Rob-McKay/pico-w-network-meter/hardware/README.md

# Hardware

One folder per target:

| Folder | Target | What's there |
|---|---|---|
| [pico/](pico/README.md) | Raspberry Pi Pico W with a Pimoroni Pico Display Pack 2.0 | A battery-powered build in a 3D-printed case: the case generator and its STL files, the wiring diagram, the bill of materials and assembly |
| [xiao-esp32c5/](xiao-esp32c5/README.md) | Seeed XIAO ESP32-C5 with a 2.2" ILI9341 TFT | The wiring, power notes and bill of materials (no case yet), and Seeed's board documents in `vendor/` |

How to build, flash and use each target is in
[docs/targets/](../docs/targets/).
