Rob-McKay/pico-w-network-meter/docs/CODING.md

# Coding conventions

These follow [pi-zephyr-inet-radio](https://github.com/Rob-McKay/pi-zephyr-inet-radio)'s
conventions, cut down to what this project needs. They apply to the
repository's own C and Python. `make test` enforces what a tool can check:

| Rule | Checked by |
|---|---|
| 0. No compiler warnings, clean clang-tidy | the build itself (`cmake/strict.cmake`) |
| 0. Zephyr's coding style | `scripts/check-style.sh`: the repository's `.clang-format` (Zephyr's, plus two blank lines kept), `checkpatch.pl`, and `scripts/check-blank-lines.py` |
| 1. Doxygen comment on every function: parameters, return values, side effects (errno included) | `scripts/check-docs.py` |
| 2. Single responsibility | review |
| 3. No unbounded string functions; buffer overflows trapped | clang-tidy, and `_FORTIFY_SOURCE=2` in the firmware |
| 4. Zephyr's driver models first | review |
| 5. Every file includes the headers it uses itself | clang-tidy's `misc-include-cleaner` (sources), `scripts/check-header-includes.py` (headers) |
| 6. No magic numbers: named constants that say what they mean | clang-tidy's `readability-magic-numbers` |

Pull requests are reviewed against these rules with the checklist in
[.github/pull_request_template.md](../.github/pull_request_template.md),
which GitHub fills into every new pull request.
[CLAUDE.md](../CLAUDE.md) summarises them for Claude Code, which reads it
in every session on this repository.

**Two targets.** Every change must pass `make test`, which builds the
firmware for both, and `make pico` and `make xiao` must build with no
warnings from this repository's code. A pull request says what was tested
on each target's hardware (a Pico W with a Display Pack, a XIAO ESP32-C5
with its TFT), or that it wasn't. When behaviour, buttons, LED colours or
settings change, update the README, `docs/USAGE.md`, the quick reference
and the guide of every target the change affects (`docs/targets/`).

## 0. The build checks every file

Every target with our code calls `meter_strict_warnings()` from
`cmake/strict.cmake`, which:

- compiles with `-Wall -Wextra -Wpedantic -Werror`: any warning fails the
  build;
- runs clang-tidy (`.clang-tidy`, the same checks as the radio's) on each
  source as it compiles, all findings as errors. clang-tidy 20 or later
  must be installed (the Docker image has 23.1.3 from PyPI).
  `-DMETER_CLANG_TIDY=OFF` skips it for a quick local build only.

Zephyr's headers are included as system headers, so only this
repository's code is checked. `scripts/clang-tidy-cross.py` gives
clang-tidy the C library headers of the cross compile.

The compiler is clang (`cmake/toolchain.cmake`): Arm Toolchain for
Embedded for the Pico W, the host's clang for the native_sim tests. The
one exception is the XIAO ESP32-C5, built with the Zephyr SDK's GCC,
because Espressif's SoC support doesn't build with clang (its CMake adds
GCC-only flags and its assembly uses GCC syntax; see
[port-esp32c5.md](port-esp32c5.md), section 6). The same rules apply there:
GCC's warnings with `-Werror`, and clang-tidy, which the wrapper gives the
target, C library headers and the `-Wno-gnu` that Zephyr gives clang
builds. Shared code that only GCC accepts is a bug: it must build with
both compilers.

When a finding is a deliberate choice, suppress that one line with a
reason, never the whole check. The `#pragma GCC diagnostic` blocks around
Zephyr's file-scope `K_*_DEFINE` and `DEVICE_DT_INST_DEFINE` macros are
such a case: their expansion can end in an empty statement, which
`-Wpedantic` reports.

Formatting is Zephyr's: tabs, 100 columns, kernel brace style, as its
`.clang-format` lays out. The repository's `.clang-format` is Zephyr's,
copied unchanged between two marker lines, plus one addition: up to two
blank lines are kept, not one. Every function is followed by two blank
lines, before whatever comes next (an `#else`, `#elif` or `#endif` that
closes the function's conditional doesn't count, and the end of the file
needs none). clang-format can't require that, so
`scripts/check-blank-lines.py` checks it. `scripts/check-style.sh` also
checks that the copy still matches the pinned Zephyr's, so a Zephyr update
that changes its `.clang-format` fails the check until the copy is
refreshed. `scripts/check-style.sh --fix` (in `make shell`) reformats and
adds missing blank lines. Where clang-format would wrap a line that must
stay whole, such as a `NOLINTNEXTLINE`, fence it with
`/* clang-format off */` and `/* clang-format on */`.

## Concurrency

Three threads share data: main (display, buttons, LED), the scan thread
(`scan_task.c`) and the net_mgmt event thread (`scanner.c`'s callbacks).
Each shared variable has one mutex, named next to it, held for every
access; nothing is shared through plain globals. The display code
(`gfx.c`, `ui.c`) and the LED cache (`status_led.c`) are main-thread only
and say so. Struct copies are compared field by field (`chan_stats_equal()`),
never with `memcmp()`, which would also compare padding.

Two pieces of state are written from any thread or interrupt, because a
restart can start anywhere: the restart note (`reset_note.c`) is written
with interrupts locked, and a note that already holds a restart's reason
is never overwritten by the main loop's uptime update. The event log
(`event_log.c`) is main-thread only.

## 1. Every function has a Doxygen comment

- `@brief`: one line saying what the function does;
- `@param` for every parameter (`@param[out]`, `@param[in,out]` for
  pointers written through);
- `@return` or `@retval` lines, except for `void` functions;
- `@sideeffects`: every change the function makes to state outside its
  own locals and the objects its pointer parameters point to. That is:
  static and global variables written, with the lock held while doing so;
  hardware driven (the panel, LEDs, radio); queues, semaphores and work
  items given, taken or scheduled; threads started, woken or blocked;
  log messages; files written; and what happens to `errno`. Write
  "None (writes only through @p out)" or "None" when there are none.
  Effects of the functions it calls count too: name them ("Those of
  set_busy() and publish()") rather than leaving them out.

  In C the paragraph always says what happens to `errno`, even if only
  "errno unchanged". The meter's own functions never set `errno`: like
  Zephyr's, they return a negative errno code instead. Among the C library
  calls they make, only `snprintf()` can set it (on an output error).
  Python functions list their effects without `errno`: printing, files,
  subprocesses, exiting.

```c
/**
 * @brief Make a finished scan visible to the display thread.
 *
 * @param ret The scan's outcome (run_scan()).
 * @return The scan's number.
 *
 * @sideeffects Under @c lock: removes faded-out access points from
 *              @c history, merges @c scanning into it, and updates
 *              @c progress. errno unchanged.
 */
static unsigned int publish(int ret)
```

Python uses the same tags in `##` comment blocks, and CMake functions in
`#` comment blocks.

Where each comment goes:

- **Public functions** (declared in a header): the header holds the
  interface documentation above, at the declaration. The definition in the
  `.c` file has a plain `/*` comment (not a second doc block) saying it is
  part of the public interface and where that is documented, followed by
  any private implementation details a reader needs:

  ```c
  /*
   * Public interface: documented in chan_stats.h.
   *
   * Adds up every access point's power in mW (not dBm), each weighted by its
   * overlap with the channel (overlap_mhz()) over CHAN_WIDTH_MHZ.
   */
  void chan_stats_channel(const struct chan_stats *s, uint8_t channel, struct chan_info *out)
  ```

- **`static` functions and test cases** (`ZTEST`): the full doc block, at
  the definition. A test case's `@brief` says what it checks.

`scripts/check-docs.py` checks both: Doxygen's output for the doc blocks,
and the C sources for the comment above every definition.

## 2. Single responsibility

A function does one job at one level of abstraction. In particular,
hardware-independent logic (`chan_stats.c`, `text_raster.c`) stays free of
Zephyr device APIs so it can be unit tested on native_sim. The screens are
tested on a fake panel (`tests/ui_render`).

## 3. Strings and buffers

`strcpy`, `strcat`, `sprintf`, `vsprintf` and `gets` are banned (clang-tidy).
Use `snprintf`, or `memcpy` with an explicit length and terminator. The
firmware is built with `_FORTIFY_SOURCE=2`, so an overflow in a C library
call stops it instead of corrupting memory.

## 4. Zephyr's driver models first

The Display Pack is described in devicetree and used through Zephyr's
drivers: the ST7789V display driver, `gpio-keys` with the input subsystem,
and `gpio-leds` with the LED API. The Wi-Fi chip is used through Zephyr's
AIROC driver and Wi-Fi management API. Write a driver only when Zephyr has
none.

## 5. Include what you use

Every file, header or source, includes the headers that declare what it
uses itself, and doesn't rely on another header to bring them in. A file
that uses `uint8_t` includes `<stdint.h>`, even if its own header already
does; one that uses `struct chan_stats` includes `"chan_stats.h"`, even if
`ui.h` includes it too. A header can then change what it includes without
breaking the files that include it.

Take each symbol from its documented public header, not the internal one
that happens to define it: `<errno.h>` for `EINVAL` (not picolibc's
`<sys/errno.h>`), `<zephyr/kernel.h>` for the kernel API,
`<zephyr/ztest.h>` for `zassert_*`, `<zephyr/sys/util.h>` for
`ARRAY_SIZE` and `IS_ENABLED`. Some symbols have public headers of their
own that the aggregate headers also include: `<zephyr/toolchain.h>`
(`BUILD_ASSERT`, `ARG_UNUSED`), `<zephyr/devicetree.h>` (`DT_*`),
`<zephyr/sys/clock.h>` (`k_timeout_t`, `MSEC_PER_SEC`). Include those
directly.

clang-tidy's `misc-include-cleaner` checks the sources on every build, and
`scripts/check-header-includes.py` checks each header on its own, in
`make test`. `.clang-tidy` lists the internal headers whose symbols come
from a public header instead (`IgnoreHeaders`), and why. Only missing
includes are reported: an include that looks unused may be in use through
a devicetree or Kconfig macro the check can't follow, so removing one is
left to review.

## 6. No magic numbers

A number in the code says what it is through its name. Every number except
0 to 4 (counting, halving and doubling, as in `2 * PAD`) is a named
constant, a `#define`, an `enum` or a `const`, whose name gives its
meaning, with a comment for its units or where it comes from:

- a field's offset in a stored format: `REC_UPTIME`, not `8`
  (`boot_record.c`)
- a register's or a pixel's bits: `RGB565_R_SHIFT`, not `11` (`rgb565.h`)
- a colour: `RGB_HIGHLIGHT`, not `0, 210, 255` (`ui.c`)
- a buffer's size: `SCAN_TEXT_MAX`, with what it holds
- a radio fact: `CHAN_SPACING_MHZ`, `CHAN_14_MHZ` (`chan_stats.c`)

Use a constant the platform already names, such as Zephyr's
`BITS_PER_BYTE` or `MSEC_PER_SEC`, rather than defining another. A
character literal (`'?'`, `' '`) names itself. Where a number is tied to
another, write the relationship (`NOTE_AT_CAUSE + 1U`), and check it with
`BUILD_ASSERT` when it must hold (`REC_ARG + sizeof(uint32_t) ==
BOOT_RECORD_SIZE`). Settings a user might change are Kconfig options
(`CONFIG_METER_*`), not constants.

clang-tidy's `readability-magic-numbers` checks it on every build. The
tests are exempt (`tests/.clang-tidy`): their numbers are the inputs they
give and the results they expect, and read best as they are.
