Rob-McKay/pico-w-network-meter/hardware/pico/case/stl/back.png

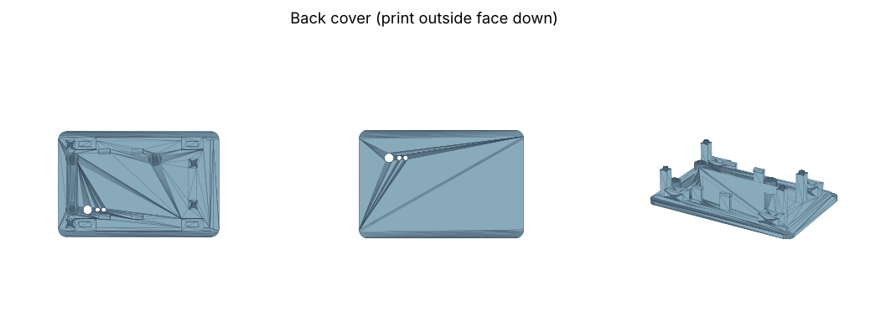
hardware/pico/case/stl/back.png
