Rob-McKay/pico-w-network-meter/hardware/pico/case/stl/buttons.png

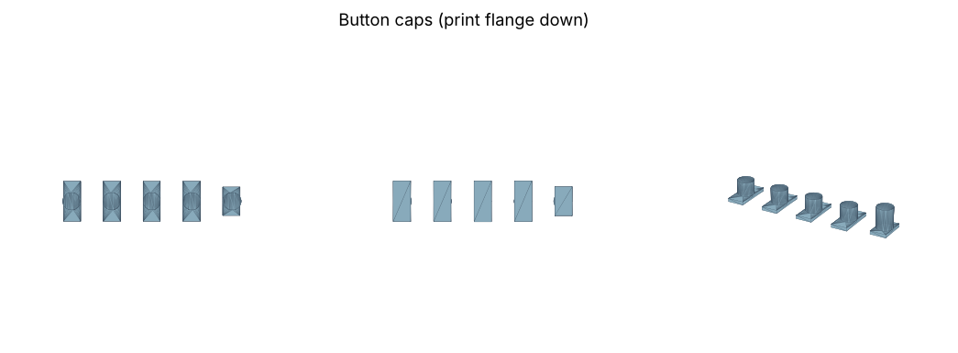
hardware/pico/case/stl/buttons.png
