Rob-McKay/pico-w-network-meter/hardware/pico/case/stl/front.png

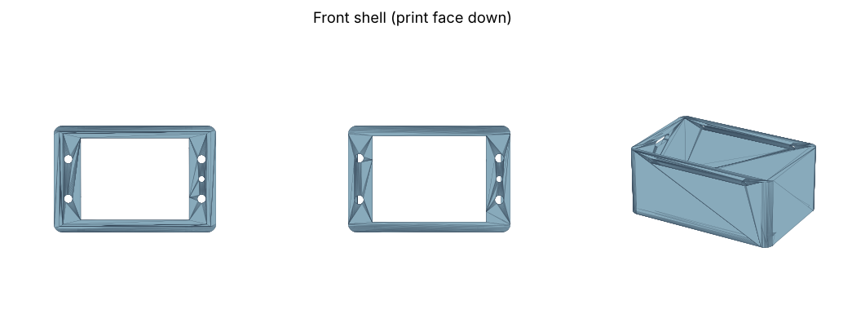
hardware/pico/case/stl/front.png
