Rob-McKay/pico-w-network-meter/hardware/pico/case/stl/back.stl

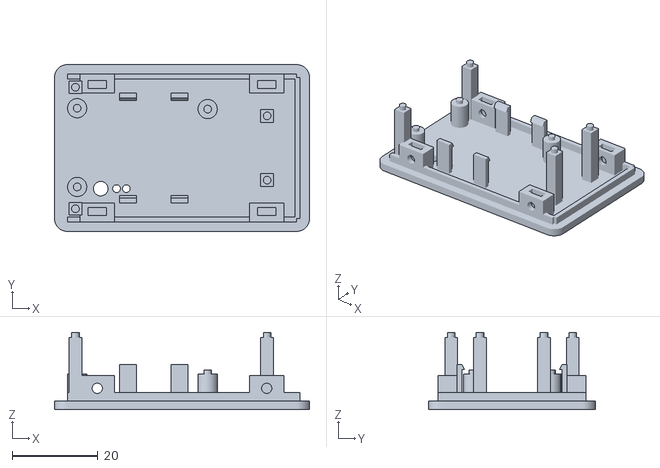
[picture p11: CAD file, 2026-11-06]
hardware/pico/case/stl/back.stl
59.6 x 39.0 x 18.1
