Rob-McKay/pico-w-network-meter/hardware/pico/case/stl/front.stl

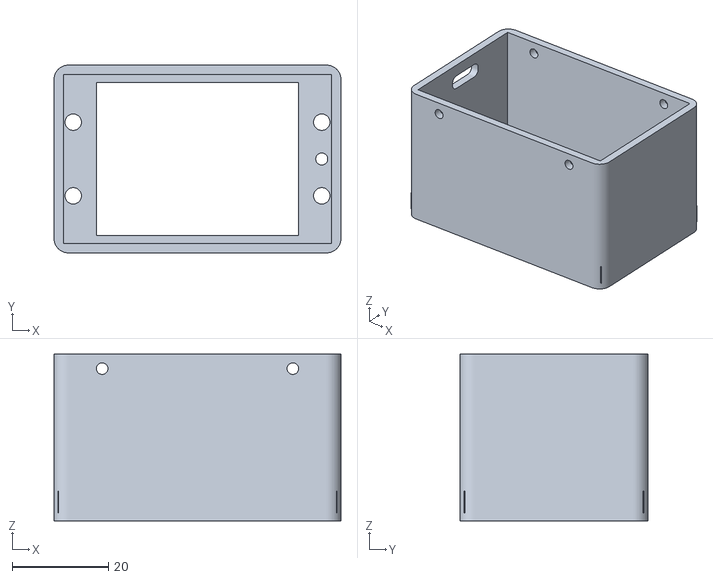
[picture p12: CAD file, 2026-11-06]
hardware/pico/case/stl/front.stl
59.6 x 39.0 x 34.6
