Rob-McKay/pico-w-network-meter/hardware/pico/case/stl/shelf.stl

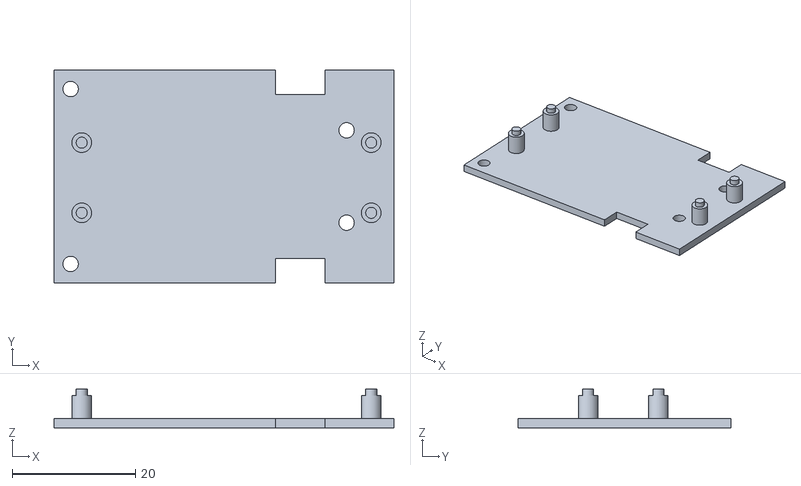
[picture p13: CAD file, 2026-11-06]
hardware/pico/case/stl/shelf.stl
55.2 x 34.6 x 6.30
