Rob-McKay/pico-w-network-meter/hardware/pico/case/stl/buttons.stl

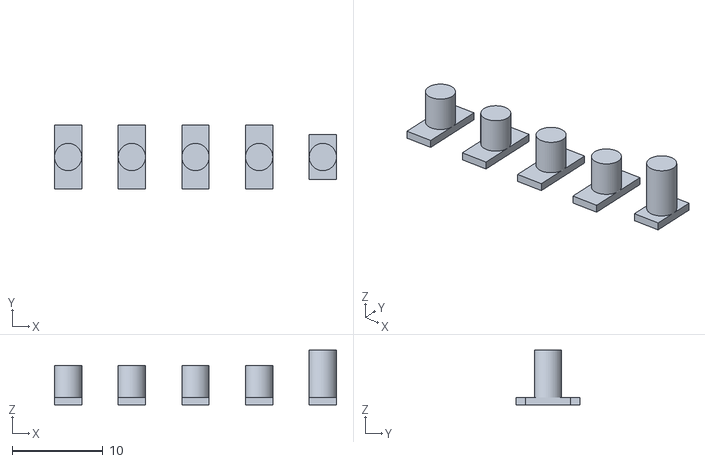
[picture p14: CAD file, 2026-11-03]
hardware/pico/case/stl/buttons.stl
31.0 x 7.00 x 6.00
