Rob-McKay/pico-w-network-meter/app/src/main.c

/*
 * Copyright (c) 2026 Rob McKay
 *
 * SPDX-License-Identifier: Apache-2.0
 *
 * Network meter: scans the 2.4 GHz Wi-Fi band every
 * CONFIG_METER_SCAN_INTERVAL_S seconds (scan_task.c) and shows per-channel
 * statistics on the display (zephyr,display: on the Pico W, a Pimoroni Pico
 * Display Pack 2.0), and on the serial console.
 *
 * Networks stay on screen after they were last heard: at full brightness
 * for CONFIG_METER_FADE_START_S seconds, then fading to
 * CONFIG_METER_FADE_MIN_PERCENT, and gone at CONFIG_METER_FADE_END_S. The screen is redrawn every
 * CONFIG_METER_REDRAW_MS while anything changes.
 *
 * Each start is logged in flash with why it happened (event_log.c,
 * reset_note.c), and shown on the events screen. A watchdog restarts the
 * meter if a thread stops responding (watchdog.c).
 *
 * Buttons: A next screen, B previous screen. On the channels screen X scans
 * now; on the networks and events screens X and Y page up and down a list
 * too long for the screen. On the events screen, X and Y together print the
 * whole log on the console.
 * RGB LED: blue while scanning, then green, amber or red for how busy the
 * recommended channel is; magenta if the latest scan failed.
 */

#include <stdbool.h>
#include <stddef.h>

#include <zephyr/input/input.h>
#include <zephyr/kernel.h>
#include <zephyr/logging/log.h>
#include <zephyr/logging/log_ctrl.h>
#include <zephyr/dt-bindings/input/input-event-codes.h>
#include <zephyr/sys/util.h>
#include <zephyr/toolchain.h>

#include "boot_record.h"
#include "chan_stats.h"
#include "controls.h"
#include "event_log.h"
#include "keys.h"
#include "paging.h"
#include "recommend.h"
#include "reset_cause.h"
#include "reset_note.h"
#include "scan_task.h"
#include "scanner.h"
#include "status_led.h"
#include "ui.h"
#include "watchdog.h"

LOG_MODULE_REGISTER(meter, CONFIG_METER_LOG_LEVEL);

/* Starts printed on the console at start-up, newest first. */
#define STARTS_ON_CONSOLE 10U
/* Longest description of a start, and a NUL. */
#define START_TEXT_MAX    40

/* Longest wait for the console to take a line of a log dump, in 10 ms
 * steps: 1 s.
 */
#define DUMP_WAIT_STEPS   100
#define DUMP_WAIT_STEP_MS 10

/* The main thread's watchdog channel; set by main() before the loop. */
static int main_watch = -1;

/* The main thread's watchdog deadline: it goes round every CONFIG_METER_REDRAW_MS. */
#define MAIN_DEADLINE_MS 5000U
BUILD_ASSERT(MAIN_DEADLINE_MS >= 4U * CONFIG_METER_REDRAW_MS,
	     "the main thread's watchdog deadline must allow several redraws");

/**
 * @brief Map how busy a channel is to the LED status that shows it.
 *
 * @param level How busy.
 * @return Green, amber or red status.
 *
 * @sideeffects None; errno unchanged.
 */
static enum status level_status(enum chan_level level)
{
	switch (level) {
	case CHAN_LEVEL_BUSY:
		return STATUS_BUSY;
	case CHAN_LEVEL_MODERATE:
		return STATUS_MODERATE;
	default:
		return STATUS_CLEAR;
	}
}


/**
 * @brief Pick the LED status: scanning (or no scan finished yet), failed,
 *        or how busy the recommended channel (on 5 GHz, 80 MHz block) is.
 *
 * @param s The networks showing.
 * @param state The scan thread's progress.
 * @param band The band whose recommendation counts: the last channels
 *        screen's.
 * @return The status.
 *
 * @sideeffects None; errno unchanged.
 */
static enum status led_status(const struct chan_stats *s, const struct scan_task_state *state,
			      enum chan_band band)
{
	struct chan_info best;

	if (state->busy || state->scans == 0U) {
		return STATUS_SCANNING;
	}
	if (state->last_error != 0) {
		return STATUS_ERROR;
	}
	if (band == CHAN_BAND_5G) {
		chan_stats_block_5g(s, recommend_5g(s), &best);
	} else {
		chan_stats_channel(s, chan_stats_recommend(s), &best);
	}

	return level_status(chan_stats_level(best.interference));
}


/* A screen A and B step through: a view, and for a channels or networks
 * screen its band.
 */
struct page {
	enum ui_view view;
	enum chan_band band; /* CHAN_BAND_COUNT: keep the band of the screen before */
};

/* The screens in order: each band's channels and networks, side by side,
 * then the events. The 5 GHz ones are left out without
 * CONFIG_METER_BAND_5G.
 */
static const struct page pages[] = {
	{UI_VIEW_CHANNELS, CHAN_BAND_2G4}, {UI_VIEW_NETWORKS, CHAN_BAND_2G4},
	{UI_VIEW_CHANNELS, CHAN_BAND_5G},  {UI_VIEW_NETWORKS, CHAN_BAND_5G},
	{UI_VIEW_EVENTS, CHAN_BAND_COUNT},
};

/* What the screen shows, to redraw only when something changes. */
struct screen {
	size_t page;              /* index in pages[] */
	enum ui_view view;        /* pages[page].view */
	enum chan_band band;      /* the band of the last channels or networks screen:
				   * the LED shows its recommendation
				   */
	size_t first;             /* networks or events screen: first row shown */
	bool full;                /* the whole screen needs drawing */
	unsigned int drawn_scans; /* scan count on screen */
	struct chan_stats shown;  /* networks on screen */
};

/**
 * @brief Change the screen shown, back to the top of its list.
 *
 * Steps through pages[], skipping the 5 GHz screens without
 * CONFIG_METER_BAND_5G. A channels or networks screen sets the band; the
 * events screen keeps it.
 *
 * @param[in,out] scr What is on screen.
 * @param step 1 for the next screen, -1 (or any other value) for the
 *        previous one.
 *
 * @sideeffects None (writes only through @p scr); errno unchanged.
 */
static void change_view(struct screen *scr, int step)
{
	const size_t n = ARRAY_SIZE(pages);

	do {
		scr->page = (scr->page + (step > 0 ? 1U : n - 1U)) % n;
	} while (!IS_ENABLED(CONFIG_METER_BAND_5G) && pages[scr->page].band == CHAN_BAND_5G);
	scr->view = pages[scr->page].view;
	if (pages[scr->page].band != CHAN_BAND_COUNT) {
		scr->band = pages[scr->page].band;
	}
	scr->first = 0;
}


/**
 * @brief Count the rows of the list on screen.
 *
 * @param scr What is on screen.
 * @return Networks or events; 0 on the channels screen.
 *
 * @sideeffects None; errno unchanged.
 */
static size_t list_length(const struct screen *scr)
{
	switch (scr->view) {
	case UI_VIEW_NETWORKS:
		return chan_stats_band_count(&scr->shown, scr->band);
	case UI_VIEW_EVENTS:
		return event_log_count();
	default:
		return 0;
	}
}


/**
 * @brief Page the list on screen up or down.
 *
 * @param[in,out] scr What is on screen.
 * @param down Down a page if true, up if false.
 * @return True if the page changed.
 *
 * @sideeffects None (writes only through @p scr); errno unchanged.
 */
static bool page_list(struct screen *scr, bool down)
{
	size_t was = scr->first;

	scr->first = paging_move(scr->first, down, list_length(scr), ui_list_rows());

	return scr->first != was;
}


/**
 * @brief Wait for the console to take what has been logged, feeding the
 *        watchdog meanwhile.
 *
 * Wakes the log thread first: left alone, it sleeps for
 * CONFIG_LOG_PROCESS_THREAD_SLEEP_MS (1 s) until CONFIG_LOG_PROCESS_TRIGGER_THRESHOLD
 * messages are waiting, so every line would take the whole wait.
 *
 * @return True if it did, false if it is still busy after a second (no
 *         one reading it).
 *
 * @sideeffects Wakes the log thread (log_thread_trigger()); sleeps the main thread, in 10 ms
 *              steps, up to 1 s; feeds @c main_watch. errno unchanged.
 */
static bool wait_for_console(void)
{
	log_thread_trigger();
	for (int i = 0; i < DUMP_WAIT_STEPS && log_data_pending(); i++) {
		watchdog_feed(main_watch);
		k_msleep(DUMP_WAIT_STEP_MS);
	}
	watchdog_feed(main_watch);

	return !log_data_pending();
}


/**
 * @brief Log one start with all its details (event_log_dump() function).
 *
 * Stops logging once the console has stopped keeping up.
 *
 * @param r The start.
 * @param arg The dump's flag (bool): set once the console stops keeping up.
 *
 * @sideeffects Logs the start; those of wait_for_console(). errno may be set by snprintf()
 *              (only on an output error).
 */
static void log_one_start(const struct boot_record *r, void *arg)
{
	bool *stalled = arg;
	char text[START_TEXT_MAX];

	if (*stalled) {
		return;
	}
	boot_record_describe(r, text, sizeof(text));
	if (r->hw_reset == BOOT_HW_UNKNOWN) {
		LOG_INF("%s: cause %u, ran %u s, detail %d, arg 0x%08x", text,
			(unsigned int)r->cause, (unsigned int)r->uptime_s, (int)r->detail,
			(unsigned int)r->arg);
	} else {
		LOG_INF("%s: cause %u, ran %u s, detail %d, arg 0x%08x, hw %u", text,
			(unsigned int)r->cause, (unsigned int)r->uptime_s, (int)r->detail,
			(unsigned int)r->arg, (unsigned int)r->hw_reset);
	}
	*stalled = !wait_for_console();
}


/**
 * @brief Log the whole event log from flash, oldest first, with all the
 *        details, a line at a time as the console takes them.
 *
 * @sideeffects Reads the flash log; logs it, and says on the footer that it did; blocks the
 *              main thread while the console takes it, feeding the watchdog. errno may be set
 *              by snprintf() (only on an output error).
 */
static void dump_log(void)
{
	bool stalled = false;
	int n;

	LOG_INF("Event log, oldest first:");
	stalled = !wait_for_console();
	n = event_log_dump(log_one_start, &stalled);
	if (n < 0) {
		LOG_ERR("Event log unavailable: %d", n);
	} else if (stalled) {
		LOG_WRN("Event log dump stopped: the console isn't reading");
	} else {
		LOG_INF("End of event log: %d starts", n);
	}
	ui_message("Event log sent to the console");
}


/**
 * @brief Act on a button: A and B change the screen; X and Y page the
 *        networks and events screens, and X scans now on the channels
 *        screen; X and Y together on the events screen dump the log.
 *
 * @param key Key code from controls_wait(), or a negative errno.
 * @param[in,out] scr What is on screen.
 * @return True if the screen needs redrawing in full.
 *
 * @sideeffects Writes @p scr through its pointer; X on the channels screen wakes the scan
 *              thread (scan_task_request()); X and Y together on the events screen log the
 *              whole event log (dump_log()). errno may be set by snprintf() (only on an output
 *              error).
 */
static bool handle_key(int key, struct screen *scr)
{
	bool list = scr->view != UI_VIEW_CHANNELS;

	switch (key) {
	case INPUT_KEY_A:
		change_view(scr, 1);
		return true;
	case INPUT_KEY_B:
		change_view(scr, -1);
		return true;
	case INPUT_KEY_X:
		if (list) {
			return page_list(scr, false);
		}
		scan_task_request();
		return false;
	case INPUT_KEY_Y:
		return list && page_list(scr, true);
	case KEYS_X_AND_Y:
		if (scr->view == UI_VIEW_EVENTS) {
			dump_log();
		}
		return false;
	default:
		return false;
	}
}


/**
 * @brief Redraw the screen if the networks, their fading, the scan count
 *        or the view have changed.
 *
 * @param[in,out] scr What is on screen.
 * @param next The networks to show.
 * @param scans Scans finished so far.
 *
 * The page shown is kept within the list, which may have shrunk.
 *
 * @sideeffects Draws on the panel (ui_show()) and updates @p scr. errno may be set by
 *              snprintf() (only on an output error).
 */
static void update_screen(struct screen *scr, const struct chan_stats *next, unsigned int scans)
{
	if (!scr->full && scans == scr->drawn_scans && chan_stats_equal(next, &scr->shown)) {
		return;
	}
	scr->shown = *next;
	scr->first = paging_clamp(scr->first, list_length(scr), ui_list_rows());
	ui_show(scr->view, scr->band, &scr->shown, scans, scr->first, scr->full);
	scr->drawn_scans = scans;
	scr->full = false;
}


/**
 * @brief Start the display, LEDs and buttons.
 *
 * Failures are logged; the meter carries on with what works.
 *
 * @sideeffects Initialises the button queue, the display (cleared) and the LEDs (backlight on,
 *              RGB LED off), and writes "Scanning..." in the footer; logs failures. errno may
 *              be set by snprintf() (only on an output error).
 */
static void start_io(void)
{
	controls_init();
	/* Clear the panel before the backlight shows its power-on contents. */
	if (ui_init() != 0) {
		LOG_ERR("Display not ready: console output only");
	}
	if (status_init() != 0) {
		LOG_ERR("LEDs not ready");
	}
	ui_message("Scanning...");
}


/**
 * @brief Record this start in the flash log, with why it happened.
 *
 * Takes the note the run before left (reset_note_take()) first, before
 * anything else can restart the meter. With CONFIG_METER_RESET_CAUSE,
 * the record also keeps the hardware's reset cause (reset_cause_take()).
 *
 * @retval 0 Recorded, or the log is open but the record couldn't be added.
 * @retval <0 Negative errno from event_log_init(): there is no log.
 *
 * @sideeffects Those of reset_note_take(), reset_cause_take() (with
 *              CONFIG_METER_RESET_CAUSE), event_log_init() and event_log_add(): starts
 *              this run's note, reads and clears the hardware's reset cause, reads and writes
 *              the flash log. errno unchanged.
 */
static int record_start(void)
{
	struct boot_note note;
	struct boot_record r;
	int ret;

	reset_note_take(&note);
	ret = event_log_init();
	if (ret != 0) {
		return ret;
	}
	boot_record_from_note(&note, event_log_last_boot() + 1U, &r);
	if (IS_ENABLED(CONFIG_METER_RESET_CAUSE)) {
		r.hw_reset = reset_cause_take();
	}
	(void)event_log_add(&r);

	return 0;
}


/**
 * @brief Print the newest starts on the console.
 *
 * @sideeffects Logs up to STARTS_ON_CONSOLE lines. errno may be set by snprintf() (only on an
 *              output error).
 */
static void print_starts(void)
{
	char text[START_TEXT_MAX];

	for (size_t i = 0; i < MIN(event_log_count(), (size_t)STARTS_ON_CONSOLE); i++) {
		const struct boot_record *e = event_log_get(i);

		boot_record_describe(e, text, sizeof(text));
		LOG_INF("Start %s (detail %d, 0x%08x)", text, (int)e->detail, (unsigned int)e->arg);
	}
}


/**
 * @brief Bring the event log up for this run: record this start, print the
 *        newest, hand them to the events screen.
 *
 * @sideeffects Those of record_start() and print_starts(); gives the UI its event source
 *              (ui_set_events()). errno may be set by snprintf() (only on an output error).
 */
static void log_start(void)
{
	if (record_start() != 0) {
		return;
	}
	print_starts();
	ui_set_events(event_log_count(), event_log_get);
}


/**
 * @brief Entry point: start the display and Wi-Fi, then redraw for ever.
 *
 * @return 0 if the Wi-Fi interface is missing (nothing else to do).
 *
 * @sideeffects Runs for ever: logs the start (log_start()), starts the watchdog and the scan
 *              thread, and drives the display, the RGB LED and the button queue; sets and feeds
 *              the main thread's watchdog channel (@c main_watch) and keeps the restart note's
 * uptime. Returns only if there is no Wi-Fi interface. errno may be set by snprintf() (only on an
 *              output error).
 */
int main(void)
{
	/* Static: struct screen holds a whole scan, too big for the stack. */
	static struct screen scr = {
		.page = 0,
		.view = UI_VIEW_CHANNELS,
		.band = CHAN_BAND_2G4,
		.full = true,
	};
	static struct chan_stats next;

	log_start();
	start_io();
	if (scanner_init() != 0) {
		ui_message("No Wi-Fi interface");
		status_set(STATUS_ERROR);
		return 0;
	}
	(void)watchdog_init();
	main_watch = watchdog_add(BOOT_WATCHED_MAIN, MAIN_DEADLINE_MS);
	scan_task_start();

	for (;;) {
		struct scan_task_state state;

		watchdog_feed(main_watch);
		reset_note_alive(k_uptime_get());

		if (handle_key(controls_wait(K_MSEC(CONFIG_METER_REDRAW_MS)), &scr)) {
			scr.full = true;
		}
		scan_task_snapshot(k_uptime_get(), &next, &state);
		status_set(led_status(&next, &state, scr.band));
		if (state.scans > 0U) { /* "Scanning..." until the first scan ends */
			update_screen(&scr, &next, state.scans);
		}
	}
}
