Rob-McKay/pico-w-network-meter/app/src/controls.c

/*
 * Copyright (c) 2026 Rob McKay
 *
 * SPDX-License-Identifier: Apache-2.0
 */

#include <errno.h>
#include <stdint.h>

#include <zephyr/dt-bindings/input/input-event-codes.h>
#include <zephyr/input/input.h>
#include <zephyr/kernel.h>
#include <zephyr/sys/clock.h>
#include <zephyr/sys/atomic.h>
#include <zephyr/toolchain.h>

#include "controls.h"
#include "keys.h"

/* Presses not yet taken by controls_wait(). */
#define QUEUED_PRESSES 4

/* Set up by controls_init(); K_MSGQ_DEFINE cannot make the queue static. */
static uint16_t press_buf[QUEUED_PRESSES];
static struct k_msgq presses;
static atomic_t ready;
/* Keys held down: the input thread only. */
static struct keys_state held;

/**
 * @brief Queue a button press, or X and Y pressed together (input thread).
 *
 * @param evt Input event.
 * @param user_data Unused.
 *
 * @sideeffects Updates @c held (keys_event()); puts the press on the @c presses queue (input
 *              thread); a press is dropped if the queue is full. errno unchanged.
 */
static void on_input(struct input_event *evt, void *user_data)
{
	int press;
	uint16_t code;

	ARG_UNUSED(user_data);
	if (atomic_get(&ready) == 0 || evt->type != INPUT_EV_KEY) {
		return;
	}
	press = keys_event(&held, evt->code, evt->value != 0);
	if (press < 0) {
		return;
	}
	code = (uint16_t)press;
	/* A full queue drops the press: the user pressed faster than the screen
	 * could follow.
	 */
	(void)k_msgq_put(&presses, &code, K_NO_WAIT);
}


INPUT_CALLBACK_DEFINE(NULL, on_input, NULL);

/*
 * Public interface: documented in controls.h.
 *
 * The ready flag is set after the queue is initialised. Zephyr's atomics are sequentially
 * consistent, so on_input() never sees the flag set before the queue exists.
 */
void controls_init(void)
{
	k_msgq_init(&presses, (char *)press_buf, sizeof(press_buf[0]), QUEUED_PRESSES);
	atomic_set(&ready, 1);
}


/*
 * Public interface: documented in controls.h.
 */
int controls_wait(k_timeout_t timeout)
{
	uint16_t code;

	if (k_msgq_get(&presses, &code, timeout) != 0) {
		return -EAGAIN;
	}

	return code;
}
