Rob-McKay/pico-w-network-meter/app/src/controls.h

/*
 * Copyright (c) 2026 Rob McKay
 *
 * SPDX-License-Identifier: Apache-2.0
 *
 * The meter's four buttons (A, B, X, Y), through Zephyr's input
 * subsystem (gpio-keys in the board overlay; on the Pico W, the Display
 * Pack's buttons).
 */

#ifndef METER_CONTROLS_H_
#define METER_CONTROLS_H_

#include <zephyr/kernel.h>
#include <zephyr/sys/clock.h>

/**
 * @brief Start queueing button presses.
 *
 * Call once, before controls_wait(); presses before it are ignored.
 *
 * @sideeffects Initialises the @c presses queue and sets @c ready, after which the input
 *              callback queues presses. errno unchanged.
 */
void controls_init(void);

/**
 * @brief Wait for a button press.
 *
 * Presses are queued (a few) between calls; releases are ignored.
 *
 * @param timeout Longest wait.
 * @return The button's key code (INPUT_KEY_A, INPUT_KEY_B, INPUT_KEY_X or
 *         INPUT_KEY_Y), KEYS_X_AND_Y for X and Y pressed together (keys.h),
 *         or -EAGAIN if none was pressed in time.
 *
 * @sideeffects Takes the oldest press off the @c presses queue; blocks the calling thread for
 *              up to @p timeout. errno unchanged.
 */
int controls_wait(k_timeout_t timeout);

#endif /* METER_CONTROLS_H_ */
