Rob-McKay/pico-w-network-meter/app/src/gfx.c

/*
 * Copyright (c) 2026 Rob McKay
 *
 * SPDX-License-Identifier: Apache-2.0
 */

#include <errno.h>
#include <stdbool.h>
#include <stddef.h>
#include <stdint.h>

#include <zephyr/device.h>
#include <zephyr/display/cfb.h>
#include <zephyr/drivers/display.h>
#include <zephyr/dt-bindings/display/panel.h>
#include <zephyr/logging/log.h>
#include <zephyr/sys/iterable_sections.h>
#include <zephyr/sys/util.h>
#include <zephyr/devicetree.h>
#include <zephyr/toolchain.h>

#include "gfx.h"
#include "rgb565.h"
#include "text_raster.h"

LOG_MODULE_REGISTER(gfx, CONFIG_METER_LOG_LEVEL);

/* Widest display supported, in pixels. */
#define MAX_WIDTH  320
/* Tallest font supported, in pixels: a band is one line of text. */
#define MAX_FONT_H 24

#define DISPLAY_NODE DT_CHOSEN(zephyr_display)

/* text_raster.c draws RGB565 high byte first, as the panel takes it over
 * SPI; the display driver may not be able to change format at run time (the
 * ST7789V's cannot).
 */
BUILD_ASSERT(DT_PROP(DISPLAY_NODE, pixel_format) == PANEL_PIXEL_FORMAT_RGB_565X,
	     "zephyr,display: set pixel-format = <PANEL_PIXEL_FORMAT_RGB_565X>");

static const struct device *const display = DEVICE_DT_GET(DISPLAY_NODE);

/* One line of text, or a strip of a filled rectangle. */
static uint16_t band[MAX_WIDTH * MAX_FONT_H];
static int disp_w;
static int disp_h;

/*
 * Public interface: documented in gfx.h.
 */
uint16_t gfx_rgb(uint8_t r, uint8_t g, uint8_t b)
{
	return raster_rgb(r, g, b);
}


/*
 * Public interface: documented in gfx.h.
 */
uint16_t gfx_fade(uint16_t color, uint8_t level)
{
	return rgb565x_fade(color, level);
}


/*
 * Public interface: documented in gfx.h.
 *
 * Checks the panel's pixel format at run time as well: the BUILD_ASSERT above covers only the
 * devicetree.
 */
int gfx_init(uint16_t bg)
{
	struct display_capabilities caps;

	if (!device_is_ready(display)) {
		LOG_ERR("Display not ready");
		return -ENODEV;
	}
	display_get_capabilities(display, &caps);
	if (caps.current_pixel_format != PIXEL_FORMAT_RGB_565X || caps.x_resolution > MAX_WIDTH) {
		LOG_ERR("Unsupported display: %ux%u, format %d", (unsigned int)caps.x_resolution,
			(unsigned int)caps.y_resolution, (int)caps.current_pixel_format);
		return -ENOTSUP;
	}
	disp_w = caps.x_resolution;
	disp_h = caps.y_resolution;

	gfx_fill(0, 0, disp_w, disp_h, bg);

	return display_blanking_off(display);
}


/*
 * Public interface: documented in gfx.h.
 */
int gfx_width(void)
{
	return disp_w;
}


/*
 * Public interface: documented in gfx.h.
 */
int gfx_height(void)
{
	return disp_h;
}


/*
 * Public interface: documented in gfx.h.
 */
const struct cfb_font *gfx_font(int height)
{
	const struct cfb_font *smallest = NULL;

	STRUCT_SECTION_FOREACH(cfb_font, f) {
		if (f->height == height && f->height <= MAX_FONT_H) {
			return f;
		}
		if (smallest == NULL || f->height < smallest->height) {
			smallest = f;
		}
	}

	return smallest;
}


/**
 * @brief Send a block of the band to the display.
 *
 * @param x Left edge.
 * @param y Top edge.
 * @param w Width: the band holds @p w x @p h pixels, row by row.
 * @param h Height.
 *
 * @sideeffects Sends the band buffer's pixels to the panel (display_write()); logs a failed
 *              write. errno unchanged.
 */
static void write_band(int x, int y, int w, int h)
{
	struct display_buffer_descriptor desc = {
		.buf_size = (uint32_t)(w * h) * sizeof(band[0]),
		.width = (uint16_t)w,
		.height = (uint16_t)h,
		.pitch = (uint16_t)w,
	};
	int ret = display_write(display, (uint16_t)x, (uint16_t)y, &desc, band);

	if (ret != 0) {
		LOG_WRN("Display write failed: %d", ret);
	}
}


/**
 * @brief Clip a rectangle to the display.
 *
 * @param[in,out] x Left edge.
 * @param[in,out] y Top edge.
 * @param[in,out] w Width.
 * @param[in,out] h Height.
 * @return True if anything is left to draw.
 *
 * @sideeffects None (writes only through its parameters); errno unchanged.
 */
static bool clip(int *x, int *y, int *w, int *h)
{
	if (*x < 0) {
		*w += *x;
		*x = 0;
	}
	if (*y < 0) {
		*h += *y;
		*y = 0;
	}
	*w = MIN(*w, disp_w - *x);
	*h = MIN(*h, disp_h - *y);

	return *w > 0 && *h > 0;
}


/*
 * Public interface: documented in gfx.h.
 *
 * Fills the shared band buffer once, then sends the rectangle in strips of as many rows as the
 * band holds.
 */
void gfx_fill(int x, int y, int w, int h, uint16_t color)
{
	if (!clip(&x, &y, &w, &h)) {
		return;
	}

	int rows = MIN(h, (int)ARRAY_SIZE(band) / w);

	for (int i = 0; i < w * rows; i++) {
		band[i] = color;
	}
	for (int row = 0; row < h; row += rows) {
		write_band(x, y + row, w, MIN(rows, h - row));
	}
}


/**
 * @brief Draw a line of text in a box one font height tall, plain or bold.
 *
 * Draws whole lines of text only: a box clipped to less than the font's height is skipped.
 *
 * @param x Left edge of the box.
 * @param y Top edge of the box.
 * @param w Box width, clipped to the display.
 * @param font Font.
 * @param text Text.
 * @param fg Text colour.
 * @param bg Background colour.
 * @param bold Bold (raster_text_bold()).
 *
 * @sideeffects Overwrites the shared band buffer and draws on the panel (write_band()). errno
 *              unchanged.
 */
static void text_box(int x, int y, int w, const struct cfb_font *font, const char *text,
		     uint16_t fg, uint16_t bg, bool bold)
{
	int h = font->height;

	if (h > MAX_FONT_H || !clip(&x, &y, &w, &h) || h != font->height) {
		return;
	}

	if (bold) {
		raster_text_bold(font, text, band, (size_t)w, fg, bg);
	} else {
		raster_text(font, text, band, (size_t)w, fg, bg);
	}
	write_band(x, y, w, h);
}


/*
 * Public interface: documented in gfx.h.
 */
void gfx_text(int x, int y, int w, const struct cfb_font *font, const char *text, uint16_t fg,
	      uint16_t bg)
{
	text_box(x, y, w, font, text, fg, bg, false);
}


/*
 * Public interface: documented in gfx.h.
 */
void gfx_text_bold(int x, int y, int w, const struct cfb_font *font, const char *text, uint16_t fg,
		   uint16_t bg)
{
	text_box(x, y, w, font, text, fg, bg, true);
}
