Rob-McKay/pico-w-network-meter/(commit log)

2026-10-25 Add Pico W Wi-Fi channel meter for the Display Pack 2.0
    A Zephyr application for the Raspberry Pi Pico W (rpi_pico/rp2040/w)
    with a Pimoroni Pico Display Pack 2.0. It scans the 2.4 GHz band every
    10 seconds and shows, per channel, the number of networks and the
    overlap-weighted interference as coloured bars, with the quietest of
    channels 1, 6 and 11 highlighted, and a list of the strongest networks.
    Buttons A/B switch screens, X scans now; the RGB LED shows scan status.
    Built in Docker like pi-zephyr-inet-radio: Arm Toolchain for Embedded
    (clang, picolibc) for the firmware, host clang for native_sim tests,
    -Werror and clang-tidy on all of our code, Doxygen check on every
    function. Zephyr is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
    [controls.c, controls.h, fake_display.c, fake_display.h]
2026-10-25 Fading display, dimmed LED, USB console, passive scans; code review fixes (#1)
    Display and LED
    - Networks are kept with the time each was last heard (ap_history.c):
    full brightness for 15 s, fading to black by 30 s, then forgotten. A
    scan that hears nothing no longer blanks the screen and is retried
    after 2 s.
    - Scanning runs in its own thread (scan_task.c); the display redraws
    every 500 ms when anything has changed.
    - The RGB LED is dimmed to 5% with PWM (pwm-leds on PWM 3A/3B/4A,
    CONFIG_METER_LED_BRIGHTNESS) and shows blue until the first scan ends.
    - The footer reads "Use ch N: clear/moderate/busy" or "Nothing heard".
    Wi-Fi
    - Passive scans by default (CONFIG_METER_SCAN_PASSIVE)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
    [controls.c, controls.h]
2026-10-26 Add grid lines and a y axis to the channel chart (#2)
    Bar heights were hard to read against the dBm labels alone: there was
    nothing to carry the eye from a label across to a bar on the far side.
    Grid lines every 10 dB now run across the chart behind the bars, brighter
    at the labelled -40/-60/-80 lines, and a vertical axis line marks the
    scale's edge.
    The grid is drawn as part of each column's background (fill_plot()),
    row by row, rather than over a cleared area, so the partial redraws
    every 500 ms still write each pixel once and don't flicker. An empty
    channel no longer blanks a label-sized box above its baseline, so the
    grid runs unbroken across it.
    Claude-Session: https://claude.ai/code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
    [main.c, ui.c]
2026-10-26 Restart when the Wi-Fi driver stops working; report failed scans (#3)
    Left running overnight, the meter stopped hearing networks after a few
    hours. Its log showed the AIROC driver failing every scan request with
    "failed to allocate a packet buffer for IOVAR": its 20-buffer pool had
    leaked away somewhere in the driver or the WHD library, and nothing
    gets the buffers back short of a restart.
    The meter made this worse. The driver reports a scan it can't start as
    -EAGAIN, which scanner_run() also used for "timed out", so scan_task
    took every failure for a finished scan that heard nothing: the LED
    showed green ("clear") instead of magenta. scanner_run() now returns
    -ETIMEDOUT for a timeout, so f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
    [main.c, scan_task.c, scanner.c, scanner.h]
2026-10-26 Show a channel's own signal apart from spill-over from its neighbours (#4)
    * Show a channel's own signal apart from spill-over from its neighbours
    Each channel's bar showed one figure: the combined power of every
    network overlapping it, its own and its neighbours' alike. A tall bar
    could mean a strong network on the channel or just a strong one next
    door, and the screen didn't say which.
    Each column now draws two bars, one inside the other: a bright, narrow
    bar for the strongest network on the channel (signal), in the middle of
    a dim, wide bar for the power reaching it from networks on other
    channels (interference). chan_stats_channel() works out that spill-over
    as a new chan_info.adjacent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
    [main.c, scan_task.c, ui.c]
2026-10-26 Bold the standard channels; name hidden networks by their MAC address (#5)
    * Bold the standard channels; name hidden networks by their MAC address
    Channels 1, 6 and 11 are the only ones that don't overlap, and the ones
    a router should use, but the chart's labels didn't set them apart. They
    are now drawn in bold. The bitmap fonts have no bold face, so
    text_raster.c inks each glyph pixel and the one to its right, within the
    glyph's own cell (raster_text_bold(), gfx_text_bold()).
    Hidden networks all showed as "(hidden)", so several couldn't be told
    apart. Since the carried AIROC patch, the driver reports their BSSID,
    so each is now named by the last three bytes of it, "hidden a2:7f:06",
    which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
    [gfx.c, gfx.h, main.c, ui.c]
2026-10-26 Count other networks on the same channel as interference (#6)
    The dim interference bar counted only networks on other channels. So a
    channel's other networks, the main interference for its strongest one,
    were left out, and on the standard channels 1, 6 and 11, which don't
    overlap each other, a bright bar rarely had any dim bar at all.
    chan_info.adjacent becomes chan_info.others: every network reaching the
    channel except its strongest, whether on the same channel or spilling
    over. The strongest counts in full, so taking its power off the total
    leaves the others' exactly. A channel with one network and nothing
    nearby still has no dim bar: nothing interferes with it.
    Claude-Session: https://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
    [main.c, scan_task.c, ui.c]
2026-10-26 Show long network names; dim the LED to 2% (#7)
    * Show long network names on the Networks screen
    Names were cut at 15 characters, so neighbouring networks with names
    like JurassicFibre_UID35630 all showed as "JurassicFibre_U" and couldn't
    be told apart.
    The signal bar only repeated the dBm figure beside it, so it is gone and
    the figure itself is coloured green, amber or red instead. That gives
    names 24 characters, enough for most whole. A longer one (SSIDs can be
    32) is shortened in the middle with "..", keeping its start and its
    end, which is where similar names usually differ (chan_ap_name(), unit
    tested).
    Claude-Session: https://c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
    [main.c, ui.c]
2026-10-28 Log every start in flash, with why; restart on crashes and hangs (#9)
    * Log every start in flash, with why; restart on crashes and hangs
    The meter restarts itself when the Wi-Fi driver gives up, but nothing
    recorded it: after a night's running the only clue was a scan count
    that had started again, and it couldn't say whether the meter had
    restarted itself, crashed, or lost power.
    Each start now adds a 20-byte record to a log in the last 64 KB of
    flash (storage_partition, carved off the end of the code partition),
    kept with Zephyr's flash circular buffer, so it survives power cuts
    and UF2 updates. Why the meter started comes from a note in __noinit
    RAM, which a restart keeps and a power cut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
    [controls.c, controls.h, event_log.c, event_log.h]
2026-11-02 Add a 3D-printable case, wiring diagram and bill of materials (#11)
    * Add a 3D-printable case, wiring diagram and bill of materials
    To run the meter on a battery, with a Pimoroni LiPo Amigo Pro charger and
    a 150 mAh LiPo, in a case.
    hardware/case/case.py generates the case as STL files with manifold3d: a
    front shell (bezel with the display window, button and LED holes, a frame
    locating the Display Pack, USB openings, screw bosses, battery ribs), a
    back cover (pockets for the charger and battery, posts holding the Pico
    into its sockets, a window onto the charger's switch, a BOOTSEL pin
    hole) and four button caps. The buttons sit in a 3.6 mm strip between the
    board's ends and the glass, so e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
    [back.stl, buttons.stl, front.stl, shelf.stl]
2026-11-03 Show hidden networks' whole MAC address; fade for longer, and not to black (#10)
    A hidden network was named by the last three bytes of its BSSID. Now that
    the name column is 24 characters, the whole address fits
    ("hidden 02:1f:3c:a2:7f:06"), so its maker can be looked up from the
    first three.
    Networks faded out too quickly: full brightness for 15 s and gone at
    30 s is three scans, and weak or hidden networks are often missed by a
    scan or two. Hidden ones, drawn in grey, were barely readable once they
    began to fade. Now a network stays bright for 60 s, fades to a floor of
    40% (CONFIG_METER_FADE_MIN_PERCENT), still readable, and is removed at
    2 minutes. The floor is in ap_history_freshness()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
    [main.c, scan_task.c]
2026-11-03 Case: mirror the charger's posts and thin their pins (#12)
    * case: mirror the charger's posts, and thin their pins
    On a printed back cover the charger's posts, PWR button hole and LED
    holes were all mirrored top to bottom against the real board: the
    positions scaled from the photo had the board's edges the other way
    round. Flip the charger's across direction where it's placed, so the
    holes, PWR button, LEDs and USB-C opening all move together.
    The pins into its mounting holes were also about 0.5 mm too wide on the
    print, so the holes are now taken as 2.1 mm and the pins are 1.8 mm.
    Claude-Session: https://claude.ai/code/session_0192d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
    [back.stl, buttons.stl, front.stl]
2026-11-03 Add a study of porting the meter to the XIAO ESP32-C5, and a plan to split the targets (#13)
2026-11-04 Name the meter's devicetree nodes by role, not by the Display Pack (#15)
    Step 1 of docs/plan-target-split.md. A second target (the XIAO
    ESP32-C5) has to give status_led.c the same node labels, and pack_*
    would name hardware it doesn't have. The labels become meter_display,
    meter_buttons, meter_rgb_led, meter_led_red/green/blue, meter_leds and
    meter_backlight. Shared comments that spoke of the Pico, Display Pack,
    ST7789V or AIROC as the only case now give them as examples, and the
    CMake project is network_meter.
    No behaviour change: the Pico's zephyr.bin and .config are
    byte-identical before and after (built with placeholder CYW43439 blobs,
    as the plan now describes), its devicetree differs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
    [controls.h, gfx.c, gfx.h, main.c, reset_note.h, scan_task.c]
2026-11-04 Move the Pico's own configuration into its board files (#16)
    Step 2 of docs/plan-target-split.md. The WHD country, the USB CDC-ACM
    console and the RP2040 watchdog note were in prj.conf or in files that
    scripts/build.sh added by hand, so a second board would inherit them or
    need its own special cases. They now live in
    app/boards/rpi_pico_rp2040_w.conf and .overlay, which Zephyr adds for
    the board by name. A plain west build for rpi_pico/rp2040/w therefore
    gets the USB console too, and build.sh passes only the country.
    usb_console.c moves to app/src/target/pico/, built under a new
    CONFIG_METER_USB_CONSOLE_FLOW (src/target/pico/Kconfig, sourced from
    app/Kconfig by a src/target/*/Kconfig glob).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
2026-11-04 Separate the meter's hardware-independent core into app/src/core (#17)
    * Move the Pico's own configuration into its board files
    CONFIG_METER_USB_CONSOLE_FLOW (src/target/pic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
2026-11-04 Add the shared hooks a second target needs, all off by default (#18)
    Step 4 of docs/plan-target-split.md. The XIAO ESP32-C5 needs settings
    the Pico W's drivers handle their own way or not at all. Each is a
    shared Kconfig option whose default keeps the Pico exactly as it is:
    - METER_WIFI_COUNTRY sets the regulatory domain through Zephyr's
    NET_REQUEST_WIFI_REG_DOMAIN (wifi_country.c, with the code checked
    by core/country_code.c). Empty leaves it to the driver, as the
    AIROC driver's WHD option needs.
    - METER_SCAN_DWELL_PASSIVE_MS and _ACTIVE_MS pass dwell times in each
    scan request; 0 is the driver's default, as before.
    - METER_RESET_CAUSE_HWINFO keeps the hardware's reset cause in eac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
    [event_log.c, event_log.h, main.c, reset_cause.c]
2026-11-04 Include what each file uses directly, and check it on every build (#19)
    Many files used a type, macro or function that reached them only through
    another header: uint8_t through a module's own header, struct chan_stats
    through ui.h, BUILD_ASSERT through zephyr/kernel.h. Such a file breaks as
    soon as that header stops including what it borrows. Each now includes
    the public header of every symbol it uses: the C library's (<stdint.h>,
    <stddef.h>), this repository's ("chan_stats.h", "boot_record.h") and
    Zephyr's (<zephyr/toolchain.h>, <zephyr/devicetree.h>,
    <zephyr/sys/clock.h>, ...).
    clang-tidy's misc-include-cleaner had been off because Zephyr's headers
    are aggregated. It is now on, for missin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
2026-11-04 Step 5: the XIAO ESP32-C5 target (make xiao) (#20)
    A second firmware target, the Seeed XIAO ESP32-C5 with an ILI9341 TFT,
    built with the Zephyr SDK's GCC because Espressif's SoC support doesn't
    build with clang. The image gains the SDK's riscv64 toolchain,
    hal_espressif (all of its blobs: Zephyr's Wi-Fi CMake checks every one),
    mbedtls, tf-psa-crypto and esptool. clang-tidy now runs on GCC compile
    commands too. The board overlay and .conf follow the port study, and a
    Zephyr patch makes the ESP32 driver report hidden networks and honour the
    scan's dwell times and bands. make xiao writes the app image and a merged
    image; make test builds both targets. The Pico image is byte-identical.
    Not yet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
    [ui.c]
2026-11-04 Step 6: docs and hardware per target (#21)
    Each target gets a guide in docs/targets/ (hardware, pins, flashing,
    console, battery, known issues, bring-up checks). The README keeps what
    both share, with a table of targets. hardware/ moves to hardware/pico/,
    and hardware/xiao-esp32c5/ gains the wiring, power notes, BOM and a
    breadboard wiring diagram for the display, matching the real layout (row
    a at the bottom, XIAO on rows c and g, TFT header on row f, wires in row
    j). USAGE.md and the quick reference cover both targets, with their
    differences in one table; the PDF is still one page. CLAUDE.md,
    docs/CODING.md and the PR template ask for both builds and a hardware
    test statement per target.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
    [back.stl, buttons.stl, front.stl, shelf.stl]
2026-11-05 make xiao: write the merged image without esptool's --format hex hint (#22)
    esptool merge-bin prints "Consider using --format hex" every time it
    writes a raw image, which is what browser flashers take. The merge only
    padded: the build already writes the flash settings into the app image's
    header. build.sh now writes 0x2000 bytes of 0xFF and then the image,
    byte-identical to merge-bin's output, without the hint.
    Claude-Session: https://claude.ai/code/session_01To75AVr4vZqZn3FenWzgcj
2026-11-05 XIAO: drop SPI DMA (TFT stayed black); record the first hardware runs (#23)
    The overlay set dma-enabled on spi2 without dmas channels or the GDMA
    controller, so on the C5 every SPI transfer failed and the ILI9341 never
    started. Without DMA the TFT works.
    The XIAO guide now records what was checked on a breadboard: the screens,
    every scan succeeding with a 5-6 s two-band sweep, channel 13 (GB), hidden
    networks, all four buttons, and the event log. A power cut and the reset
    button both show as "power on". It also lists what's still open (the RGB
    LED, software restarts, the console with no host, long runs, battery), and
    gives esptool 4's write_flash for macOS's Python 3.9.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
2026-11-05 5 GHz, stage 1: keep 5 GHz networks and work out their channels (#24)
    The XIAO's radio hears both bands, but the meter threw its 5 GHz results
    away. Each network now has a band. chan_stats takes the 5 GHz channels
    36-177, counts a 5 GHz network in full across its 80 MHz block (Zephyr's
    results carry no width), and recommends the quietest allowed block:
    fewer networks, then no DFS, then the lower block.
    CONFIG_METER_BAND_5G (on for the XIAO only) keeps 5 GHz results, and the
    console reports them per channel with the best block. The screens stay
    2.4 GHz until stage 2: the list and counts filter to 2.4 GHz, and the
    Pico's screenshots are byte-identical. The XIAO also gets a 4 KB log
    buffer, as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
2026-11-06 5 GHz, stage 2: Channels 5 GHz screen; Networks and LED follow the band (#25)
    On the XIAO, a Channels 5 GHz screen follows the 2.4 GHz one. It charts
    the 80 MHz blocks 36-48 to 149-161, labelled by first channel (bold
    without DFS, highlighted when recommended), with the footer "Use 52-64:
    clear". The Networks list (5 GHz channels right-aligned in three
    characters) and the LED follow the band of the last Channels screen
    viewed. The console's empty-block line reads "clear, nothing heard" in
    place of -127 dBm, and the level names and allowed blocks now come from
    the core (chan_level_name(), chan_5g_blocks()).
    The Pico's screens are byte-identical in the screen tests; new tests and
    screenshots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
2026-11-06 Docs: the 5 GHz screens checked on the XIAO (#27)
    On hardware, the Channels 5 GHz screen follows Channels.
    - Its blocks are labelled 36, 52, 100, 116, 132 and 149, and the counts
    sit over their channels' columns.
    - 36-48 is red, "52" is highlighted, and the footer reads
    "Use 52-64: clear".
    - The Networks 5 GHz list has right-aligned channel numbers.
    The LED isn't fitted yet, so it stays unchecked.
    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
2026-11-06 A Networks screen per band: the 2.4 GHz list was unreachable with A (#28)
    On the XIAO, Networks listed the band of the last Channels screen, which
    going forward was always 5 GHz, so the 2.4 GHz list was unreachable with
    A. Each band now has its own Networks screen beside its Channels screen:
    Channels, Networks, Channels 5 GHz, Networks 5 GHz, Events. The Pico's
    order is unchanged. The LED shows the band of the screen last viewed.
    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
2026-11-06 Pico W: keep the Wi-Fi chip out of deep sleep, with a WHD patch (#26)
    Every few hours, from 16 minutes to 2 days apart, the Pico W's scans
    stopped working until the meter restarted itself. A run of debug builds
    (branch debug-wifi-whd) traced it: the Pico side kept working (requests
    sent, credits to spare, no buffers lost, the interrupt line idle), but the
    CYW43439 stopped answering. Its gSPI side still read healthy, its
    backplane and firmware didn't. Between requests WHD lets the chip's bus
    sleep, which on this chip clears its keep-SDIO-on bit and puts it in its
    save/restore deep sleep, and it is the waking from that which fails. A
    debug build that kept the bus up scanned for 24 h 26 min (7,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
    [scan_task.c, scanner.c, scanner.h, wifi_awake.h]
2026-11-06 Case: legs under the shelf, hooks for the charger, the lead round the shelf (#29)
    * Case: legs under the shelf, hooks for the charger, the lead round the shelf
    The shelf was held against the Pico only by the battery and charger
    behind it, and the charger stayed on its posts' 1 mm pins only because
    the battery pressed it there: with no battery, or the 4.3 mm 150 mAh
    one, it could fall off them. And the power lead had to be threaded
    through slots in the shelf.
    - Four legs rise from the back cover to the shelf, with pins into holes
    in it, so the shelf is held between the Pico and the cover whatever
    the battery is. They're on the cover, not the shelf, so both parts
    still print without su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
    [back.stl, front.stl, shelf.stl]
2026-11-07 Style: two blank lines after every function; fix the chan_level cast (#32)
    Functions are now followed by two blank lines, not one. clang-format
    can't require that, so:
    - .clang-format in the repository: Zephyr's, copied unchanged between
    marker lines, plus MaxEmptyLinesToKeep: 2, since Zephyr's file (by
    LLVM's default) cuts two blank lines to one. scripts/check-style.sh now
    formats with it, and checks the copy still matches the pinned Zephyr's.
    Editors pick it up too. SeparateDefinitionBlocks: Always was tried and
    left out: it cuts two blank lines to one before a macro that defines
    something, such as INPUT_CALLBACK_DEFINE.
    - scripts/check-blank-lines.py checks that after a funct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
    [controls.c, event_log.c]
2026-11-07 Code review: fix a NULL dereference, an over-eager erase and a terminal injection (#33)
    * Style: two blank lines after every function; fix the chan_level cast
    something, su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
    [event_log.c, event_log.h, gfx.c, main.c]
2026-11-07 Rules: no magic numbers; name the ones the code had (#34)
    -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
    [main.c, scan_task.c, scanner.c]
2026-11-08 Carry a Zephyr patch for each network's channel width; log it (#31)
    Zephyr's scan result carries only the primary channel, so the meter
    assumed 80 MHz for every 5 GHz network. Espressif's scan record already
    has the width and centre channels; the patch adds bandwidth and
    center_channel to struct wifi_scan_result, a 160 MHz enum value, and
    fills them in the ESP32 driver (160 MHz from vht_ch_freq2 under the
    current VHT signalling). The debug line logs them. Checked on a XIAO
    ESP32-C5 over 19 hours: every result has a width and a correct centre.
    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
    [scanner.c]
2026-11-09 Count each network on the channels of its own width (#35)
    The ESP32 driver reports each network's width and centre channel (#31),
    but the figures still took every 5 GHz network to fill its 80 MHz
    block and every 2.4 GHz one to be 20 MHz. chan_stats now weights each
    network by how much of its own spectrum overlaps a channel, on both
    bands, falling back to the old model where no width is given (the
    Pico). A block's figures (chan_stats_block_5g) count every network
    using any of its channels; the recommendation, LED, footer and console
    use them.
    The console's debug list names hidden networks by BSSID, and the
    per-channel lines say "clear" instead of "-127 dBm".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
2026-11-11 Pico W: name a restart the hardware watchdog made (#36)
    A meter running the deep-sleep fix restarted on its own after 4 days 9
    hours: no Wi-Fi failure, no crash, no hung thread, so the event log could
    only say 'restart after 4d09h'. On a Pico W with nothing attached that
    leaves two causes, the hardware watchdog (the whole system stopped for
    4 s, too stuck for the meter's own watchdog to note it) or a supply dip
    short enough to leave RAM intact, and telling them apart decides what to
    look at next.
    Zephyr's hwinfo driver can't say on the RP2040 (its chip reset register
    keeps the last power-on), but the watchdog's reason register can: its
    TIMER bit is set only by a watchdog timeout, and every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
    [main.c, reset_cause.c, reset_cause.h, reset_cause_hwinfo.c]
